Loetlicht/tiktok-matrix/print/Matrix_Diffusor_0.8mm_132mm_v5.stl

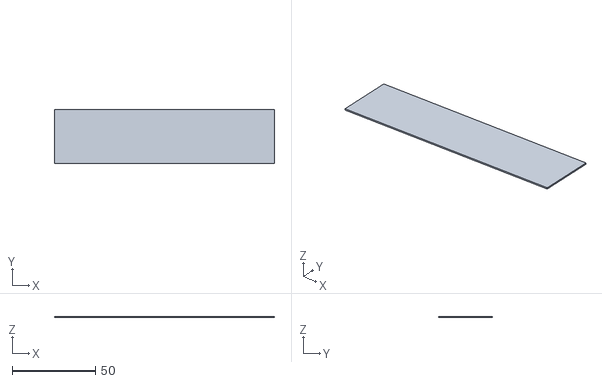
[picture p4: CAD file, 2026-10-20]
print/Matrix_Diffusor_0.8mm_132mm_v5.stl
132.0 x 32.4 x 0.78
