Loetlicht/tiktok-matrix/print/Matrix_Schale_mit_Zierleiste_AMS_v5.3mf

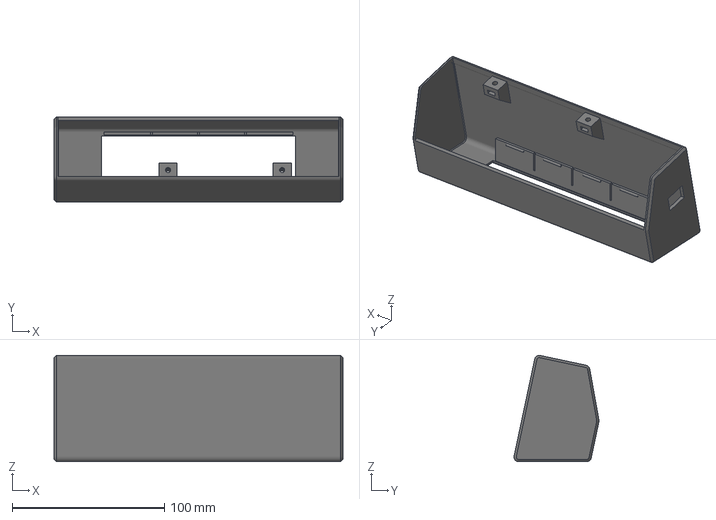
[picture p5: CAD file, 2026-10-20]
print/Matrix_Schale_mit_Zierleiste_AMS_v5.3mf
190.0 x 55.9 x 69.9 mm
