Loetlicht/tiktok-matrix/print/Matrix_Rueckdeckel_schwarz.stl

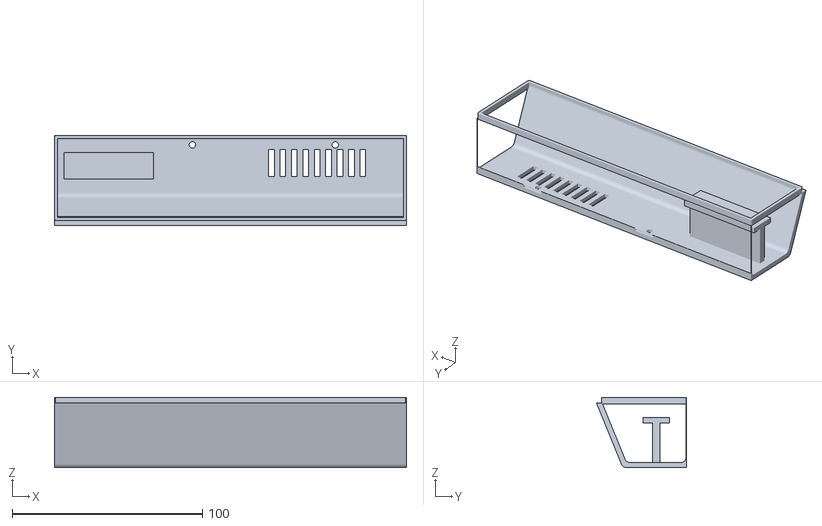
[picture p6: CAD file, 2026-10-20]
print/Matrix_Rueckdeckel_schwarz.stl
184.8 x 47.2 x 37.0
