Loetlicht/tiktok-matrix/print/Matrix_TESTDRUCK_Rastnasen_v5.stl

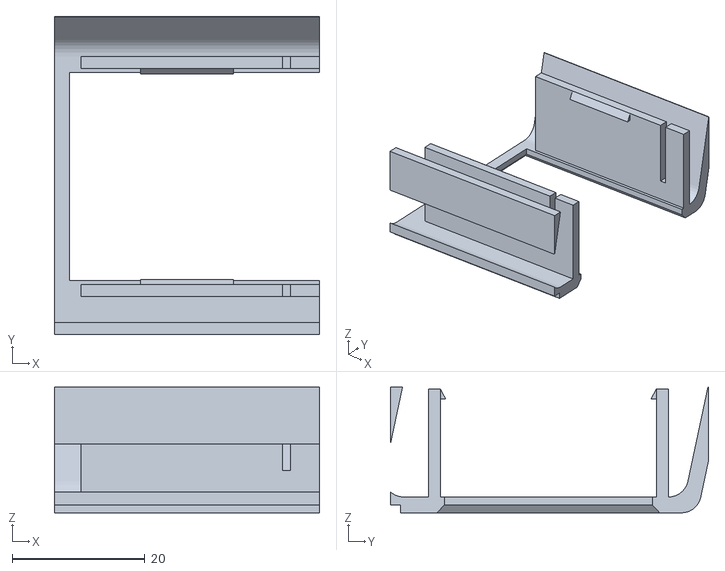
[picture p7: CAD file, 2026-10-20]
print/Matrix_TESTDRUCK_Rastnasen_v5.stl
40.0 x 48.0 x 19.0
