Loetlicht/tiktok-matrix/print/Matrix_Zierleiste_gelb.stl

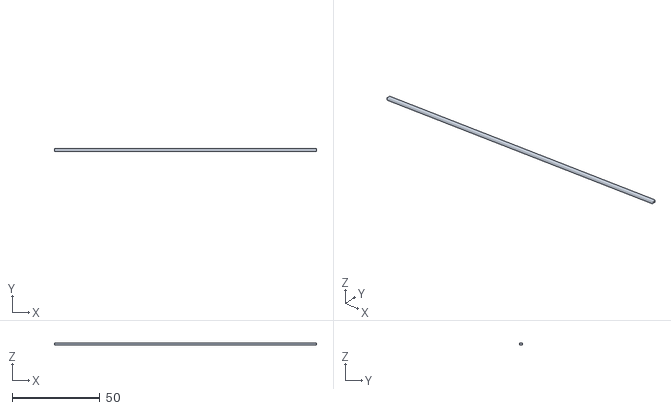
[picture p8: CAD file, 2026-10-20]
print/Matrix_Zierleiste_gelb.stl
149.4 x 1.90 x 1.15
