Loetlicht/tiktok-matrix/print/Matrix_Schale_schwarz_Front-unten_v5.stl

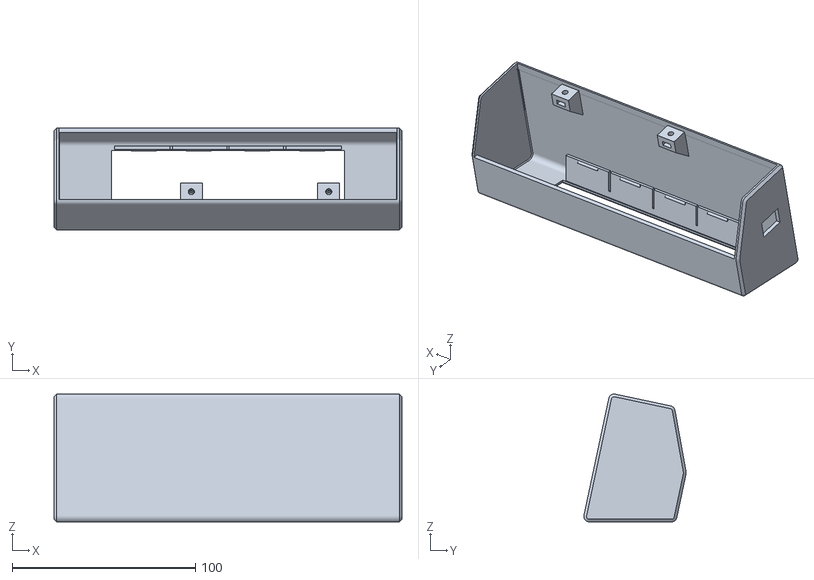
[picture p9: CAD file, 2026-10-20]
print/Matrix_Schale_schwarz_Front-unten_v5.stl
190.0 x 55.9 x 69.9
