Loetlicht/tiktok-matrix/firmware/matrix_tiktok/secrets_example.h

// Diese Datei nach "secrets.h" kopieren und die eigenen WLAN-Daten eintragen.
// secrets.h wird nicht auf GitHub hochgeladen (.gitignore).
#pragma once
#define WIFI_SSID "DeinWLAN"
#define WIFI_PASS "DeinPasswort"
