Loetlicht/tiktok-matrix/(commit log)

2026-10-20 TikTok-Matrix: Gehäuse v5, Firmware und Doku
    - Druckdateien: Schale v5 (Rastnasen 4,3 mm weiter hinten für
    Matrix + Diffusor 14,52 mm), AMS-3MF mit Zierleiste, Rückdeckel,
    Diffusor, Testdruck
    - Firmware: Uhrzeit, Datum mit ISO-Kalenderwoche, TikTok-Follower
    - README, Stückliste, Bilder, Lizenz CC BY-NC-SA 4.0
    Claude-Session: https://claude.ai/code/session_01XNkrVBuNMyfW3vM8EAmSQa
    [Matrix_Diffusor_0.8mm_natur-oder-rauchgrau.stl, Matrix_Rueckdeckel_schwarz.stl, Matrix_Schale_mit_Zierleiste_AMS_v5.3mf, Matrix_Schale_schwarz_Front-unten_v5.stl, Matrix_TESTDRUCK_Rastnasen_v5.stl, Matrix_Zierleiste_gelb.stl, stueckliste.csv]
2026-10-20 Diffusor auf 132 mm Breite vergrössert
    Matrix_Diffusor_0.8mm_132mm_v5.stl ersetzt die 128,4-mm-Platte;
    README und Stückliste angepasst.
    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
    [Matrix_Diffusor_0.8mm_132mm_v5.stl, Matrix_Diffusor_0.8mm_natur-oder-rauchgrau.stl, stueckliste.csv]
